nkjcqvcpi/CD-ElectronicCircuit/顶部失真.PNG

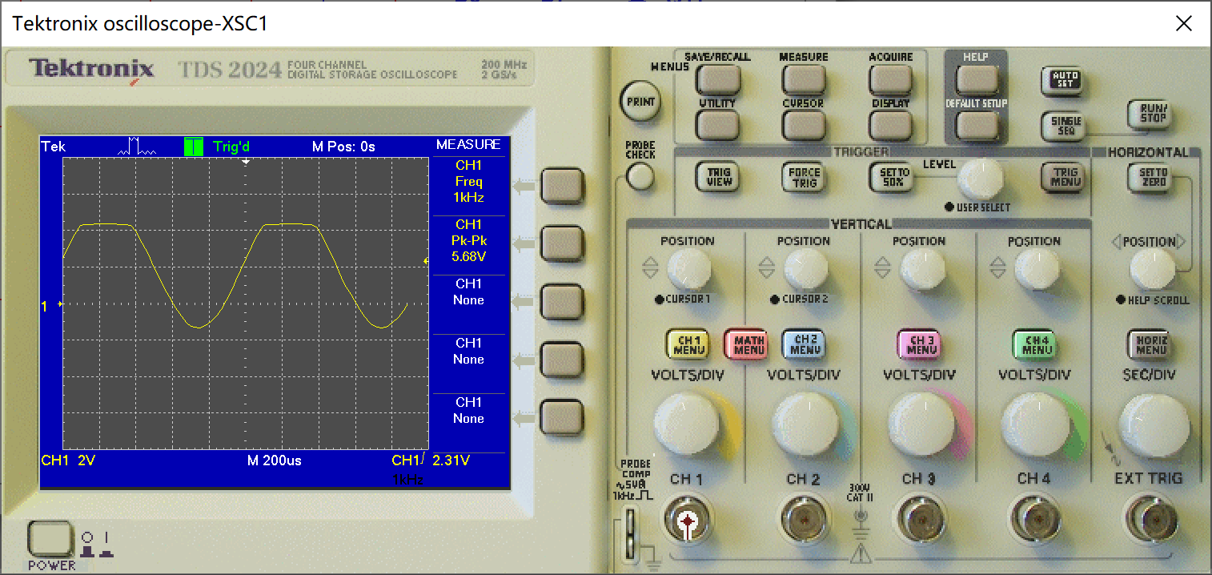
顶部失真.PNG
