nkjcqvcpi/CD-ElectronicCircuit/3D PCB model (front).png

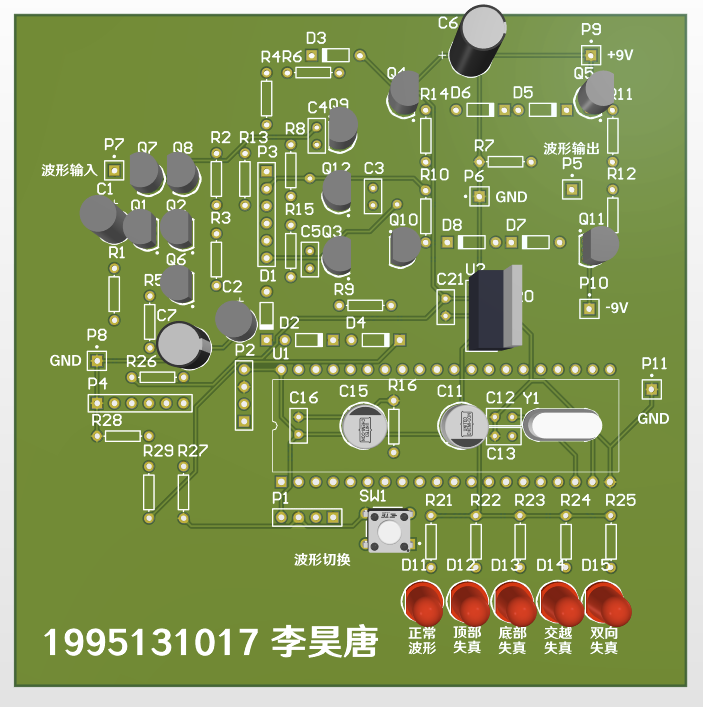
3D PCB model (front).png
