nkjcqvcpi/CD-ElectronicCircuit/3D PCB model (back).png

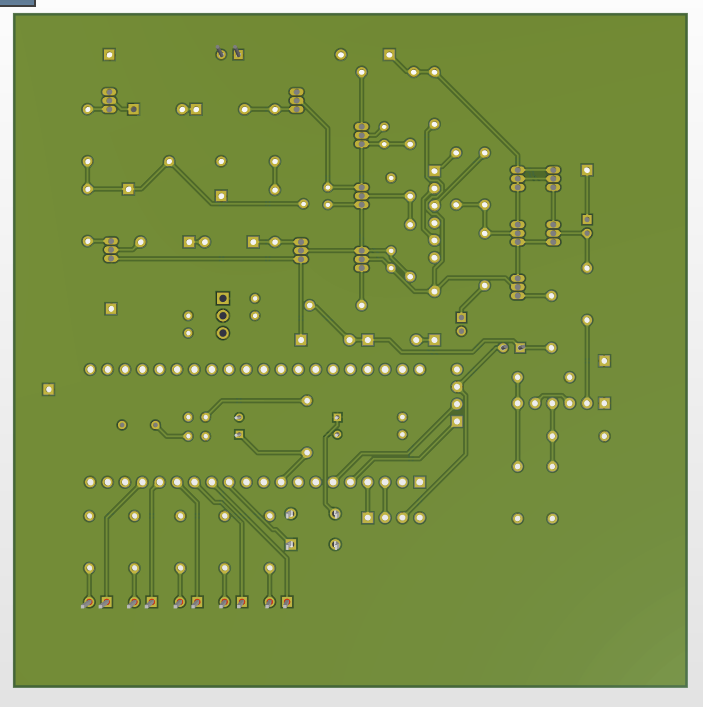
3D PCB model (back).png
