nkjcqvcpi/CD-ElectronicCircuit/SIM_p2.pdf

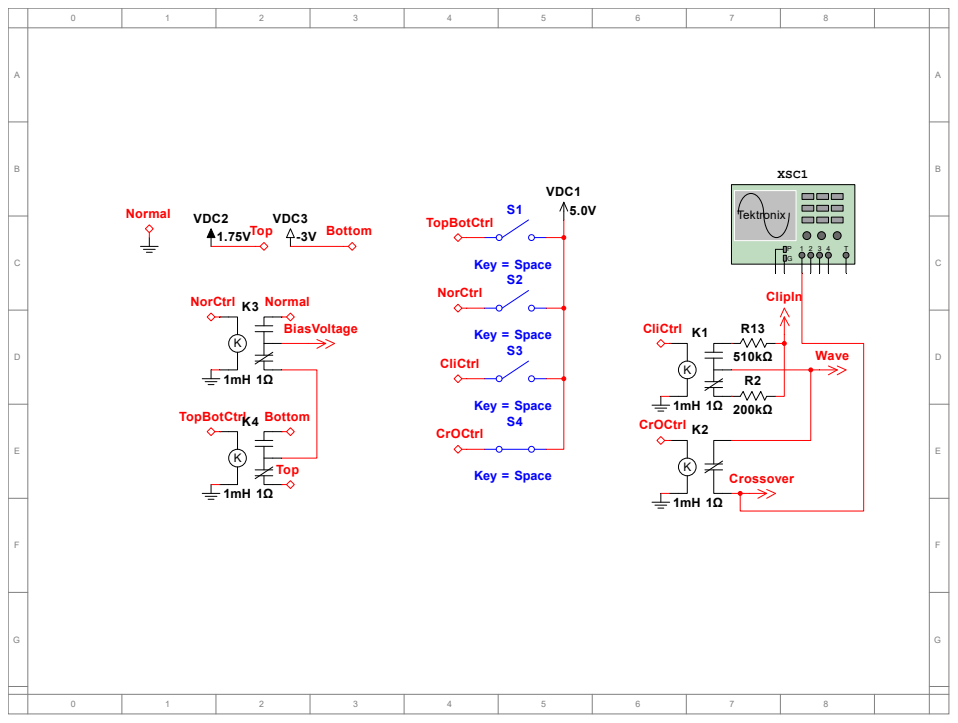
[picture p33: page 1]
Crossover; Top; Bottom; Normal; BiasVoltage; CrOCtrl; TopBotCtrl; NorCtrl; CliCtrl; XSC1; Tektronix; Wave; ClipIn; Key = Space S2; Key = Space S3; Key = Space S4; Key = Space; VDC1 5.0V; VDC2 1.75V; VDC3 -3V
