nkjcqvcpi/CD-ElectronicCircuit/PCB circuit_v3.pdf

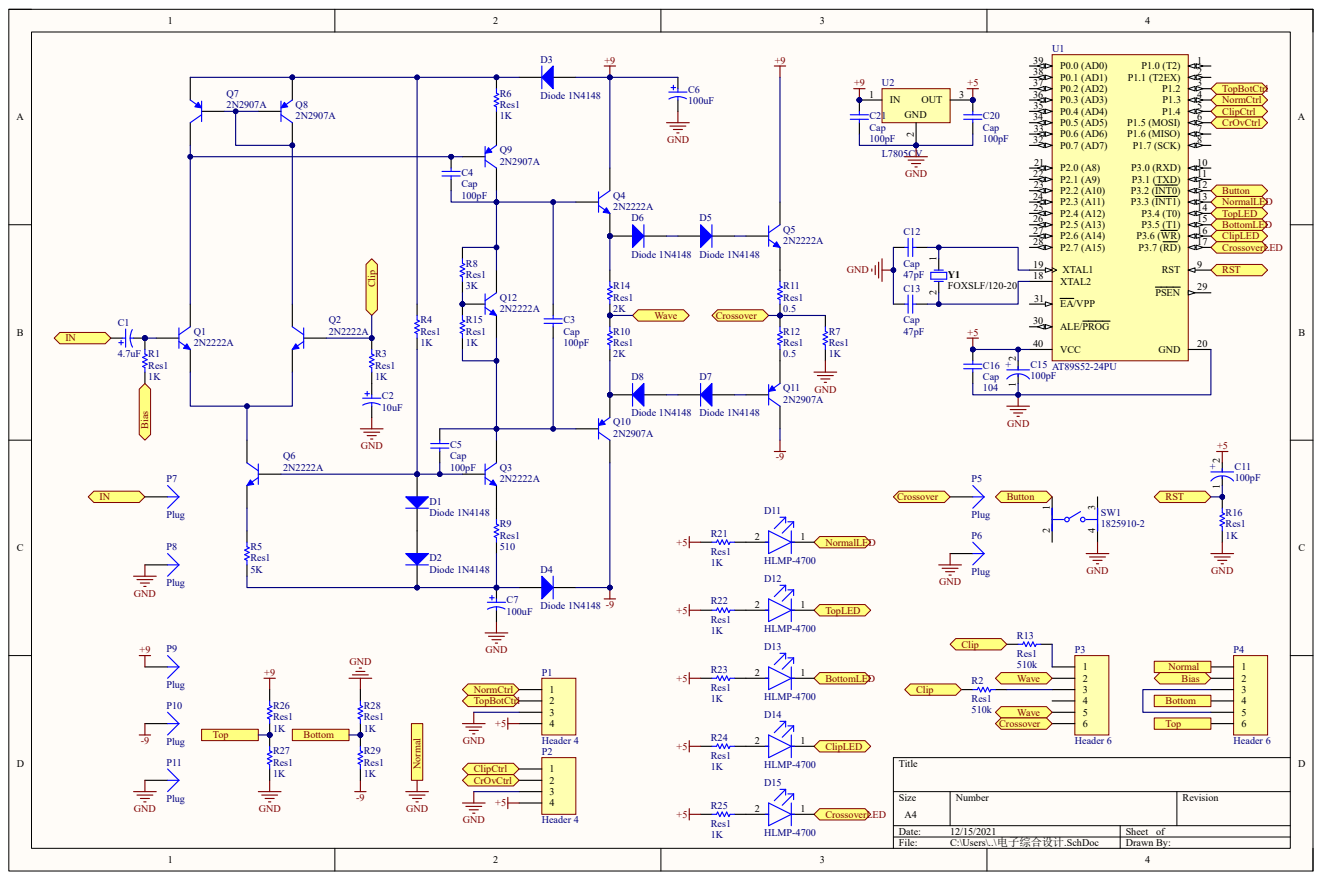
[picture p34: page 1]
