nkjcqvcpi/CD-ElectronicCircuit/PCB.pdf

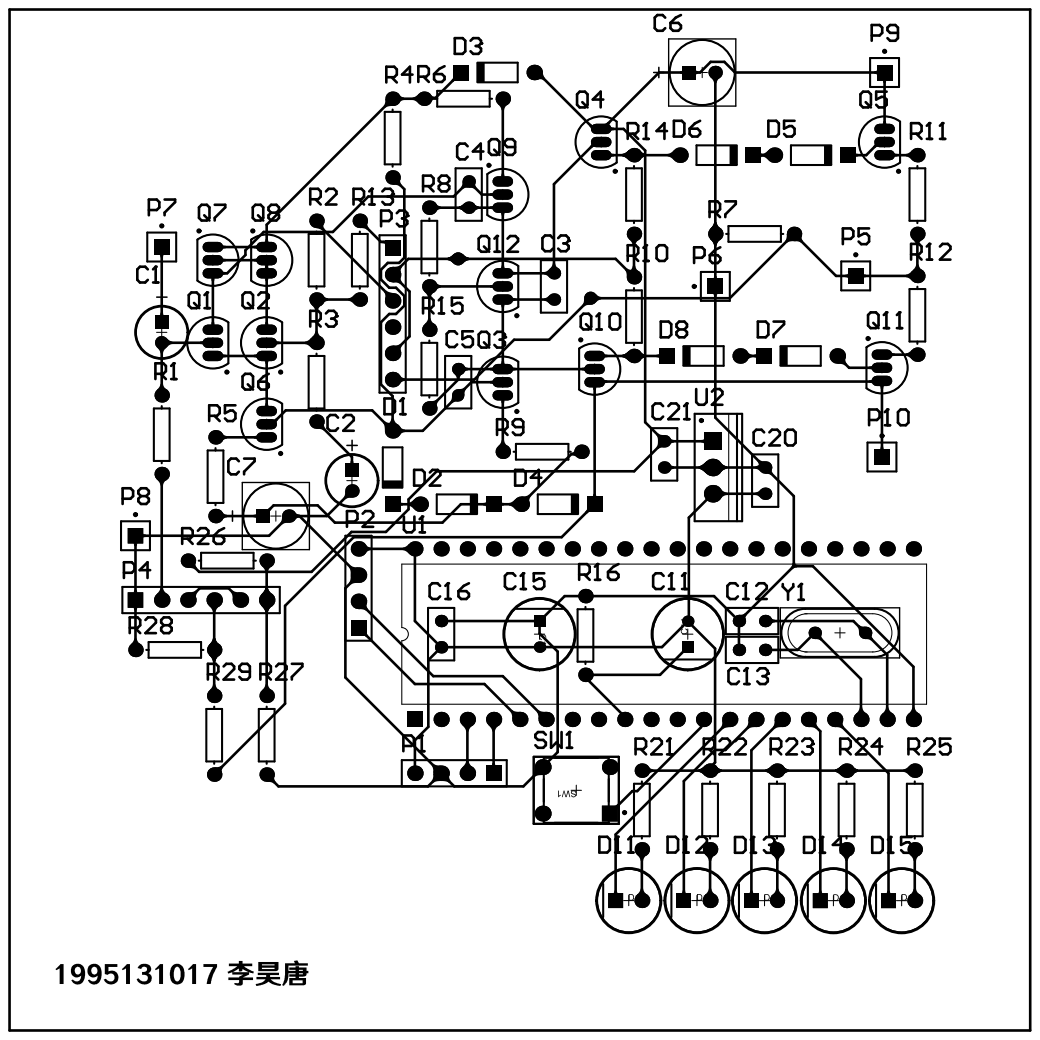
[picture p35: page 1]
