nkjcqvcpi/CD-ElectronicCircuit/SIM_p1.pdf

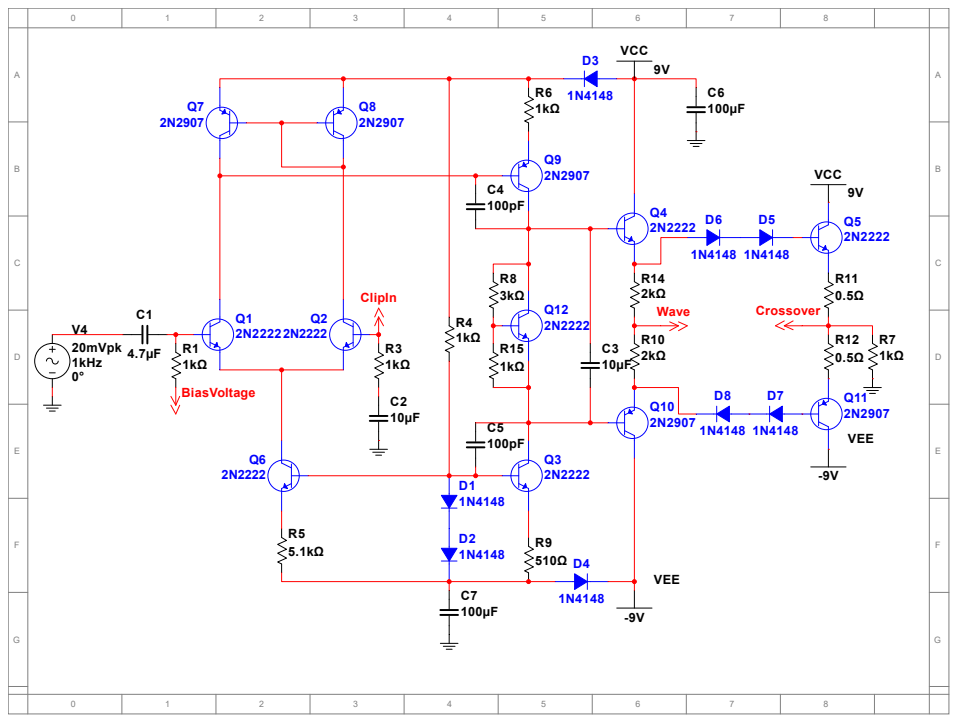
[picture p36: page 1]
