nkjcqvcpi/CD-ElectronicCircuit/PCB circuit_v1.pdf

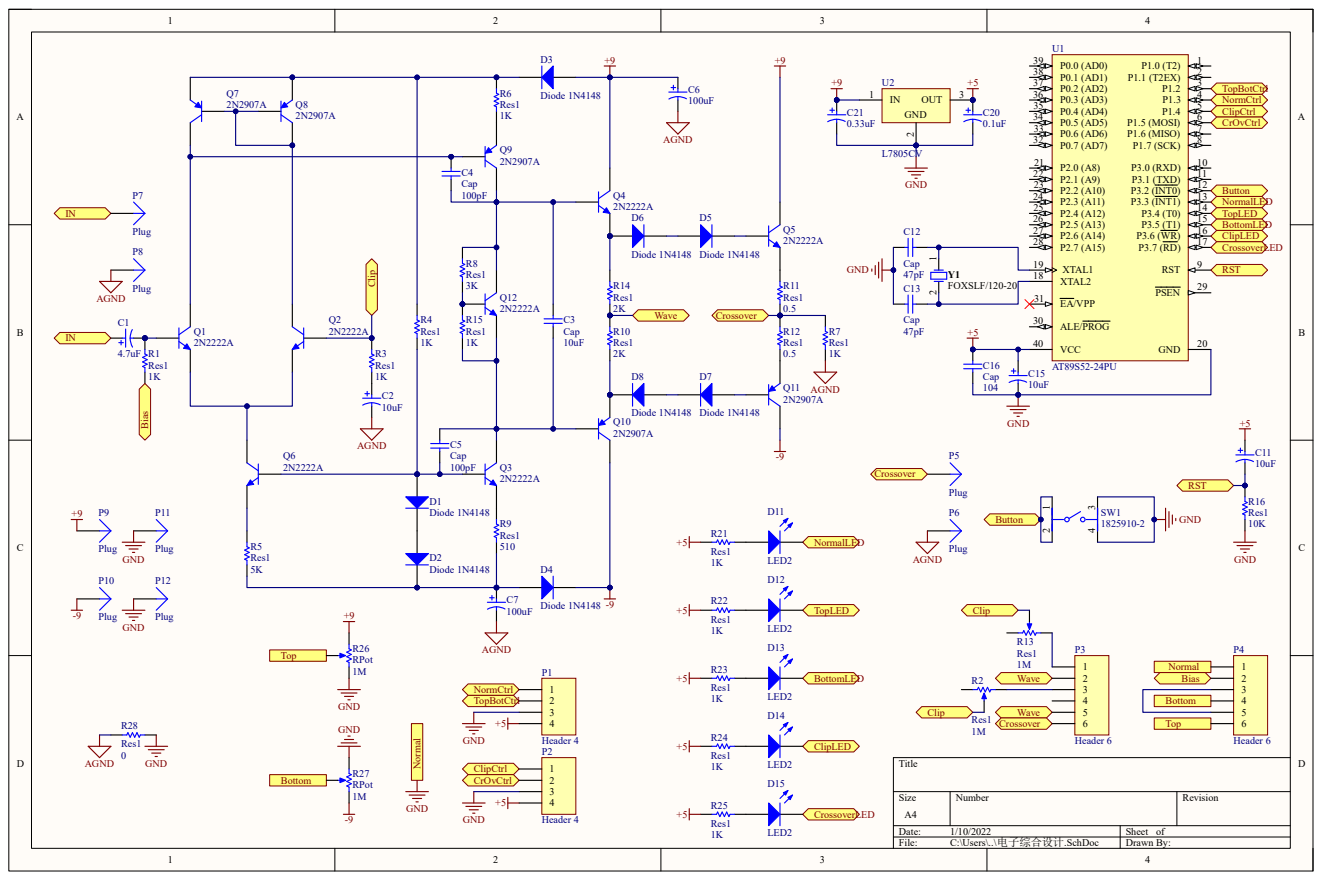
[picture p37: page 1]
