nkjcqvcpi/CD-ElectronicCircuit/PCB circuit_v2.pdf

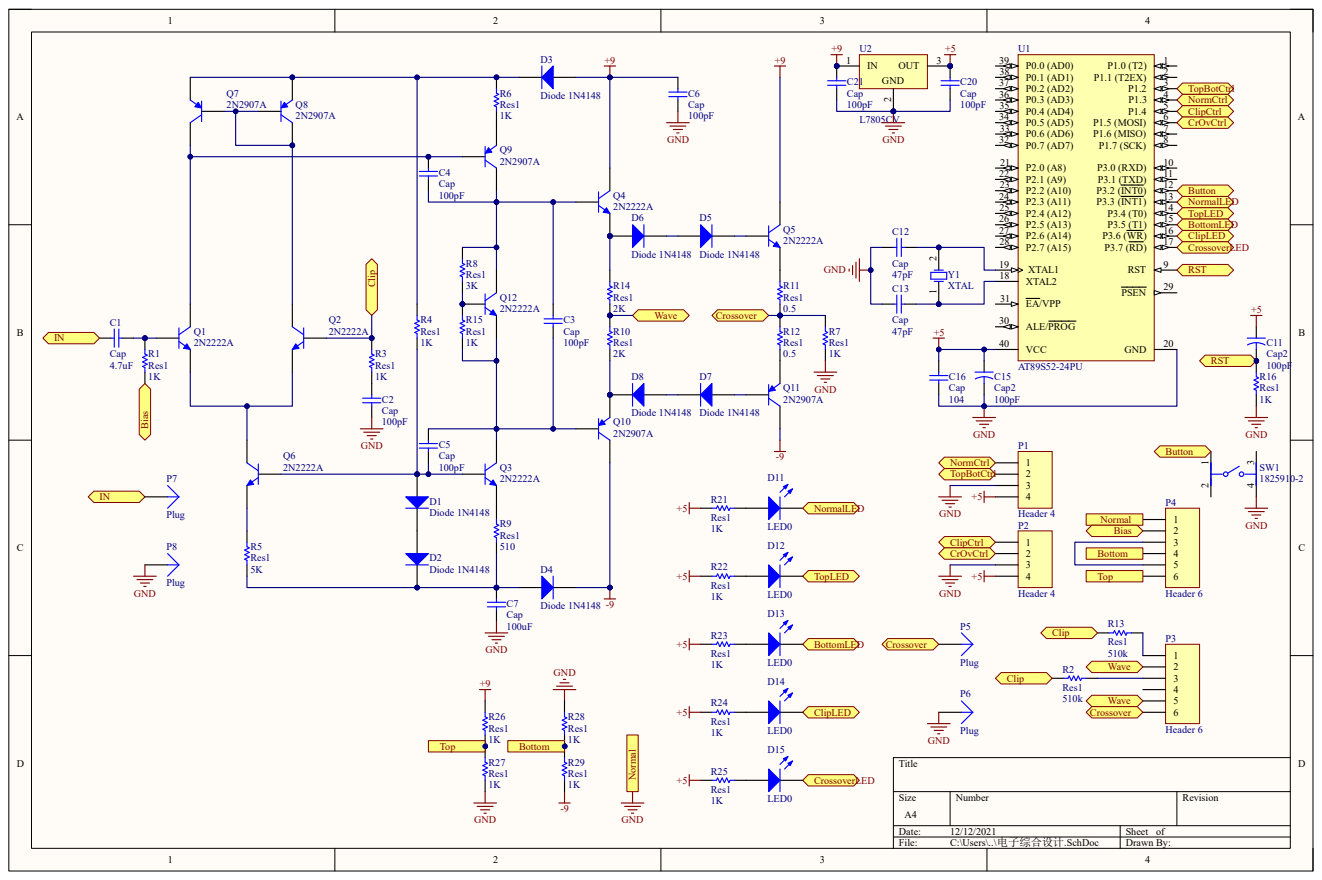
[picture p38: page 1]
