nkjcqvcpi/CD-ElectronicCircuit/res/9013,8550等SPICE模型/ss9013.cir

* SS9013 NPN EPITAXIAL SILICON TRANSISTOR ELECTRICAL PARAMETERS
*---------------------------------------------------------------
* Vcbo (40V) & Vceo (20V)
* 1W Output Amplifier of Potable Radios in Class B Push-pull Operation.
*---------------------------------------------------------------
* MODEL PARAMETERS FROM MEASURED DATA: SS9013-HBU
*--------------------------------------------------------------- 
*BeginSpec
*JV: Ic/Ib=10
*OA: Vce=1
*FB: Vce=1
*VV: Ic/Ib=10
*CB:
*EB:
*ST: Ic/Ib=10
*GB: Vce=10
*EndSpec
*BeginTrace
*JV: 0,1,100.00E-6,.1,1,3,0,0,-1 (27)
*OA: 1,1,100.00E-6,.1,1,3,0,0,-1 (27)
*FB: 0,1,100.00E-6,.1,1,3,0,0,-1 (27)
*VV: 0,1,100.00E-6,.1,1,3,0,0,-1 (27)
*CB: 0,1,.1,50,1,3,0,0,-1 (27)
*EB: 0,1,.1,10,1,3,0,0,-1 (27)
*ST: 0,1,100.00E-6,.1,1,3,0,0,-1 (27)
*GB: 0,1,100.00E-6,.1,1,3,0,0,-1 (27)
*EndTrace
*BeginParam
*IS=34.068E-15 (10.000E-21,1.0000E-6,0)
*BF=200 (1,1.5000E3,0)
*NF=1 (.8,1.2000,0)
*VAF=67 (0,1.0000E3,0)
*IKF=1.1640 (10.000E-3,20,0)
*ISE=12.368E-15 (0,1,0)
*NE=2 (1,2,0)
*BR=15.173 (.1,500,0)
*NR=1 (.1,5,0)
*VAR=40.840 (0,1.0000E3,0)
*IKR=.26135 (10.000E-3,20,0)
*ISC=1.9055E-15 (0,1,0)
*NC=1.0660 (1,3,0)
*NK=.5 (.1,5,0)
*RE=20.000E-3 (0,100.00E3,0)
*RB=63.200 (0,100,0)
*RC=.7426 (0,100.00E3,0)
*CJE=35.300E-12 (0,1,0)
*VJE=.808 (.35,1.5000,0)
*MJE=.372 (.1,1,0)
*CJC=17.400E-12 (0,1,0)
*VJC=.614 (.35,1.5000,0)
*MJC=.388 (.1,1,0)
*FC=.5 (.1,1.5000,0)
*TF=10.000E-9 (0,1,0)
*XTF=10 (0,100.00E3,0)
*VTF=10 (0,100.00E3,0)
*ITF=1 (0,100.00E3,0)
*PTF=0 (0,360,0)
*TR=10.000E-9 (0,1,0)
*EG=1.0999 (.69,5,0)
*XTB=1.4025 (0,100.00E3,0)
*XTI=3 (.1,100.00E3,0)
*EndParam
*DEVICE=SS9013,NPN
* SS9013 NPN model
* updated using Model Editor release 10.5.0 on 11/28/08 at 08:11
* The Model Editor is a PSpice product.
.MODEL SS9013 NPN
+ IS=34.068E-15
+ BF=200
+ VAF=67
+ IKF=1.1640
+ ISE=12.368E-15
+ NE=2
+ BR=15.173
+ VAR=40.840
+ IKR=.26135
+ ISC=1.9055E-15
+ NC=1.0660
+ RE=20.000E-3
+ RB=63.200
+ RC=.7426
+ CJE=35.300E-12
+ VJE=.808
+ MJE=.372
+ CJC=17.400E-12
+ VJC=.614
+ MJC=.388
+ TF=10.000E-9
+ XTF=10
+ VTF=10
+ ITF=1
+ TR=10.000E-9
+ EG=1.0999
+ XTB=1.4025
