nkjcqvcpi/CD-ElectronicCircuit/(list of files, drawings)

Other design files:
SIM_v1.ms14
SIM_v2.ms14
SIM_v3.ms14
